Chicken-Fried/Cave-Uno/cave_topo_artwork.png

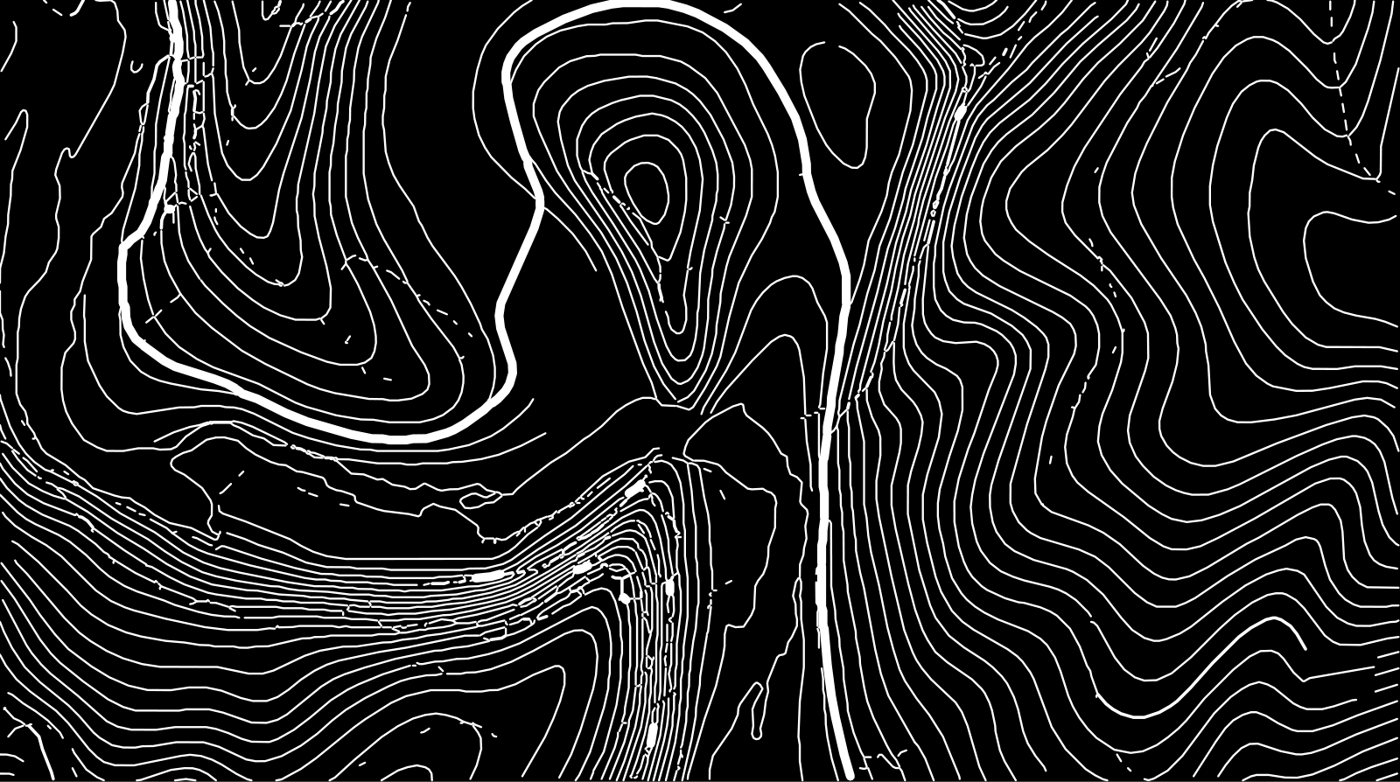
cave_topo_artwork.png
