Chicken-Fried/Cave-Uno/cave_topo_pcb_55pct.png

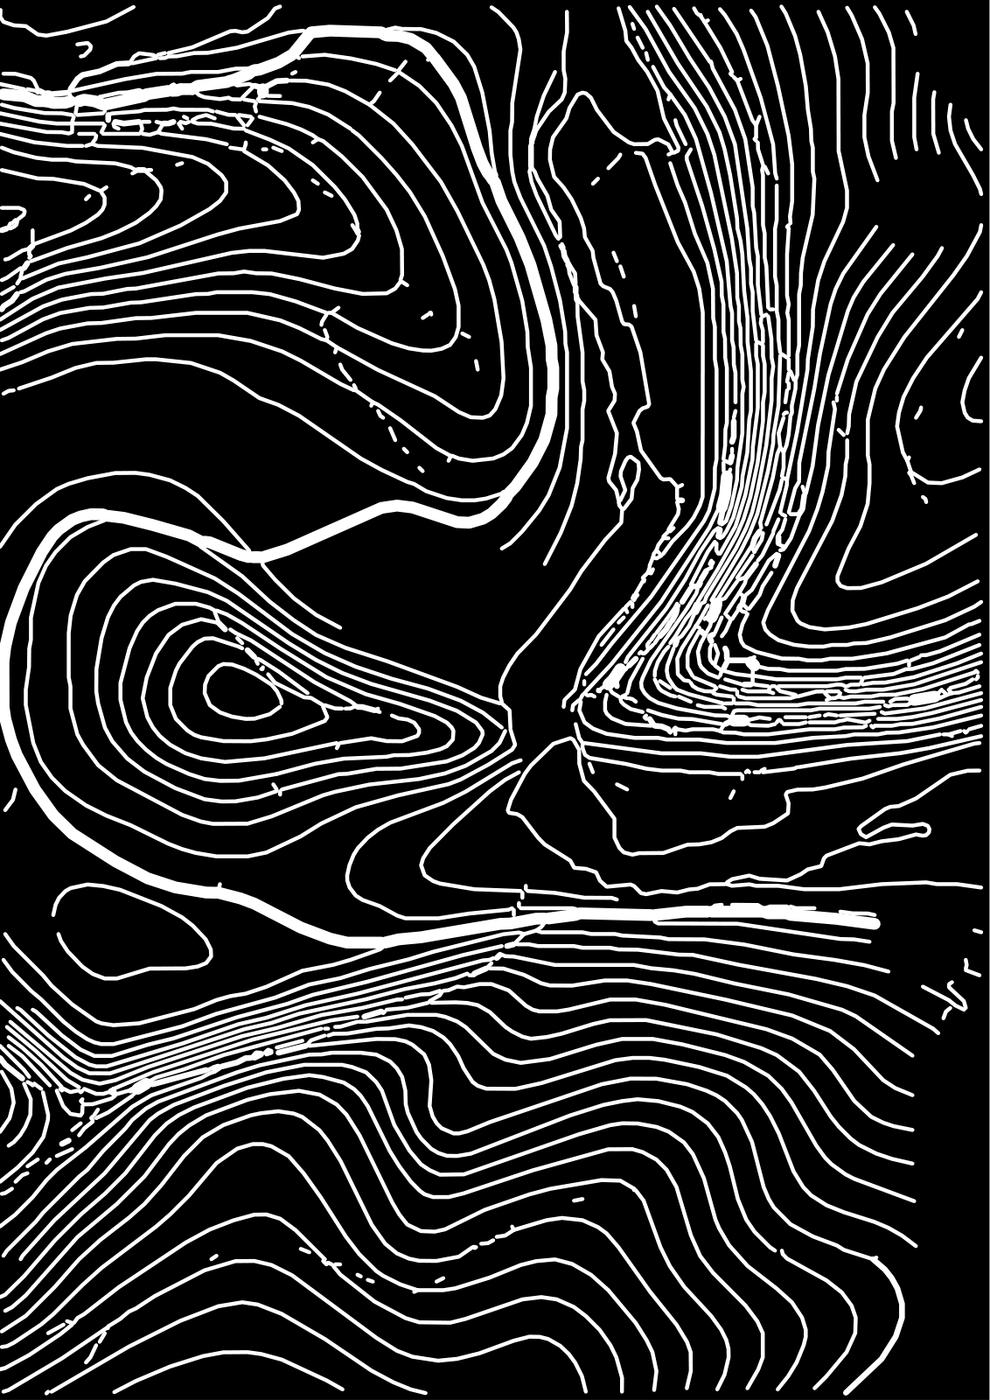
cave_topo_pcb_55pct.png
