Chicken-Fried/Cave-Uno/cave_uno_face_avant_github.png

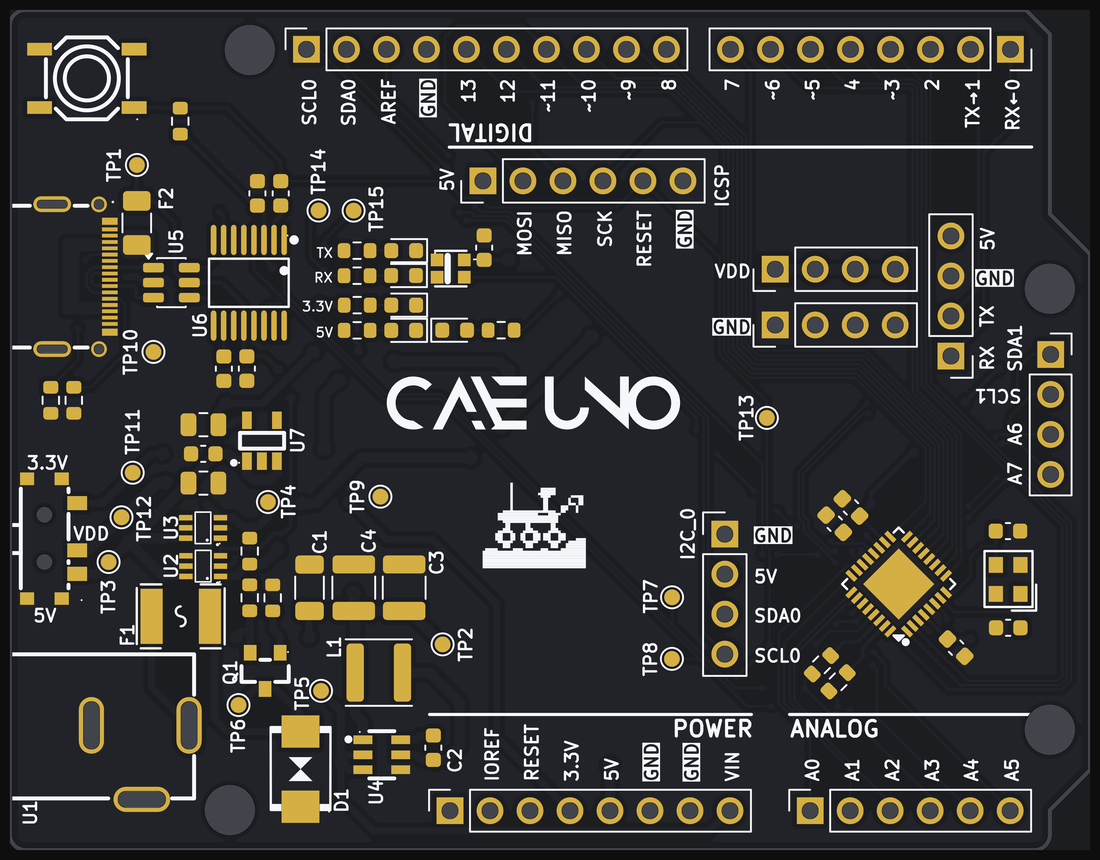
cave_uno_face_avant_github.png
