Chicken-Fried/Cave-Uno/cave_uno_front_portrait.png

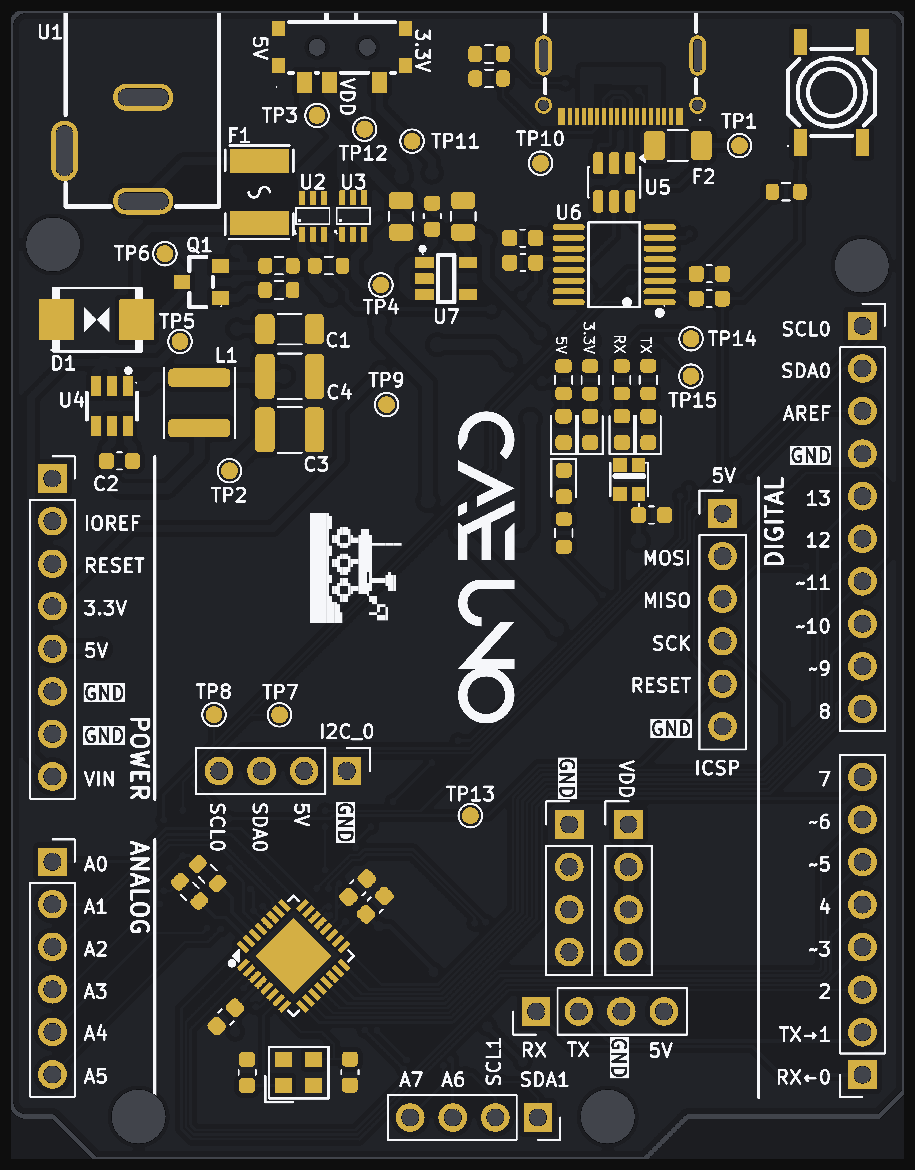
cave_uno_front_portrait.png
