Chicken-Fried/Cave-Uno/arduino_uno.kicad_pcb

## KiCad design arduino_uno.kicad_pcb (2026-10-28)

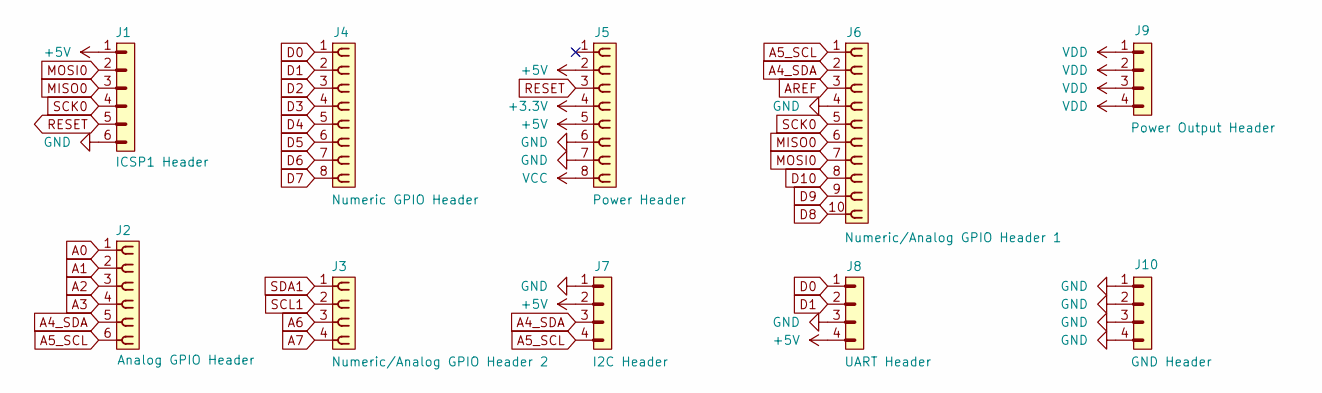
[picture p12: schematic 04_headers_io.kicad_sch]

Parts:
J1: ICSP1 Header; PinHeader_1x06_P2.54mm_Vertical; LCSC Part C505159
J2: Analog GPIO Header; PinSocket_1x06_P2.54mm_Vertical; LCSC Part C5224026
J3: Numeric/Analog GPIO Header 2; PinSocket_1x04_P2.54mm_Vertical; LCSC Part C5116530
J4: Numeric GPIO Header; PinSocket_1x08_P2.54mm_Vertical; LCSC Part C5224027
J5: Power Header; PinSocket_1x08_P2.54mm_Vertical; LCSC Part C5224027
J6: Numeric/Analog GPIO Header 1; PinSocket_1x10_P2.54mm_Vertical; LCSC Part C5116489
J7: I2C Header; PinHeader_1x04_P2.54mm_Vertical; LCSC Part C589358
J8: UART Header; PinHeader_1x04_P2.54mm_Vertical; LCSC Part C589358
J9: Power Output Header; PinHeader_1x04_P2.54mm_Vertical; LCSC Part C41425294
J10: GND Header; PinHeader_1x04_P2.54mm_Vertical; LCSC Part C42391438

Connections:
+3.3V: J5.4; also elsewhere on the board
+5V: J1.1, J5.2, J5.5, J7.2, J8.4; also elsewhere on the board
A0: J2.1; also elsewhere on the board
A1: J2.2; also elsewhere on the board
A2: J2.3; also elsewhere on the board
A3: J2.4; also elsewhere on the board
A4_SDA: J2.5, J6.2, J7.3; also elsewhere on the board
A5_SCL: J2.6, J6.1, J7.4; also elsewhere on the board
A6: J3.3; also elsewhere on the board
A7: J3.4; also elsewhere on the board
AREF: J6.3; also elsewhere on the board
D0: J4.1, J8.1; also elsewhere on the board
D1: J4.2, J8.2; also elsewhere on the board
D2: J4.3; also elsewhere on the board
D3: J4.4; also elsewhere on the board
D4: J4.5; also elsewhere on the board
D5: J4.6; also elsewhere on the board
D6: J4.7; also elsewhere on the board
D7: J4.8; also elsewhere on the board
D8: J6.10; also elsewhere on the board
D9: J6.9; also elsewhere on the board
D10: J6.8; also elsewhere on the board
GND: J1.6, J5.6, J5.7, J6.4, J7.1, J8.3, J10.1, J10.2, J10.3, J10.4; also elsewhere on the board
MISO0: J1.3, J6.6; also elsewhere on the board
MOSI0: J1.2, J6.7; also elsewhere on the board
RESET: J1.5, J5.3; also elsewhere on the board
SCK0: J1.4, J6.5; also elsewhere on the board
SCL1: J3.2; also elsewhere on the board
SDA1: J3.1; also elsewhere on the board
VCC: J5.8; also elsewhere on the board
VDD: J9.1, J9.2, J9.3, J9.4; also elsewhere on the board

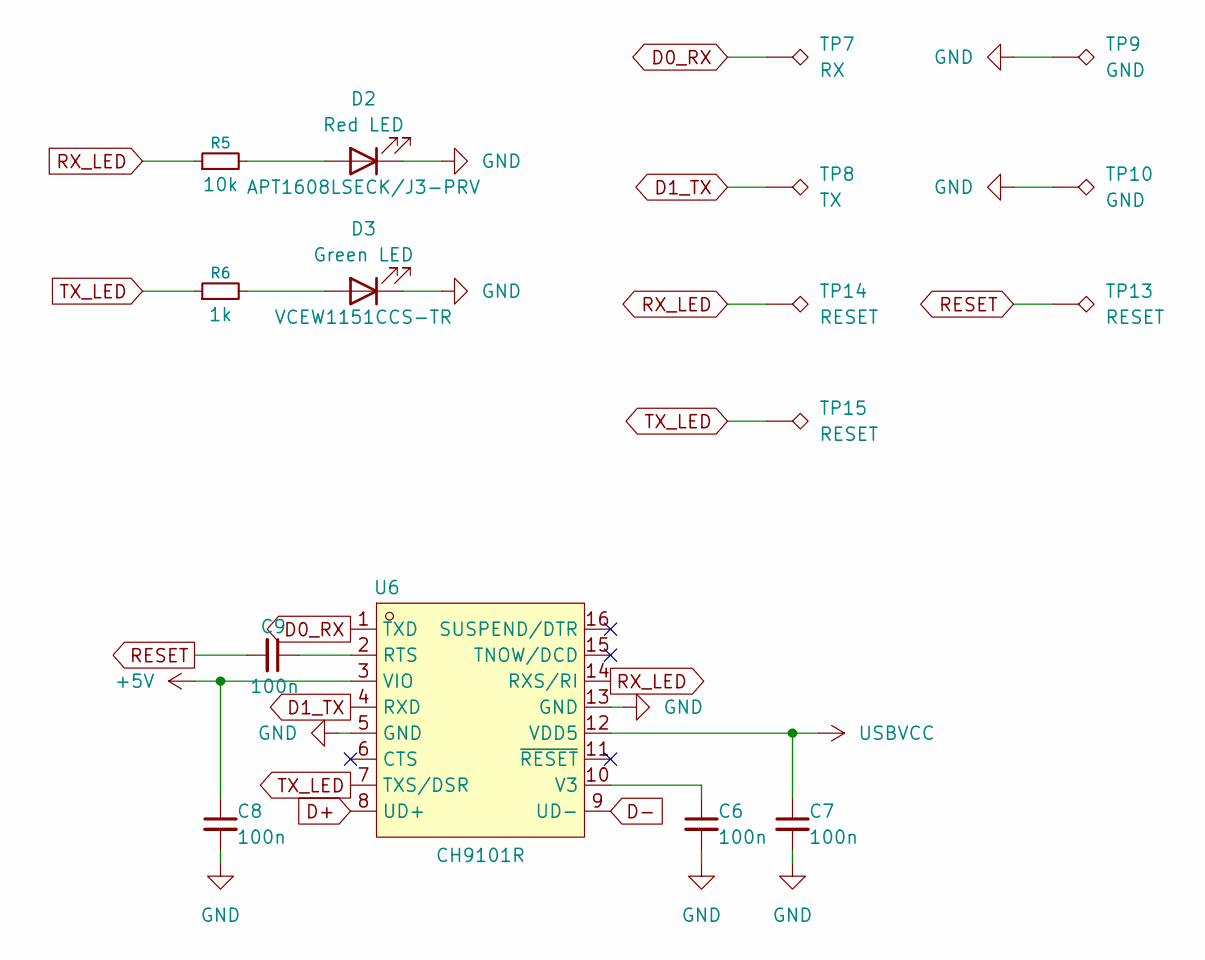
[picture p13: schematic 02_usb_uart.kicad_sch]

Parts:
C6, C7, C8, C9: 100n; C_0603_1608Metric; LCSC Part C346190
D2: Red LED; LED_0603_1608Metric; LCSC Part C5357909
D3: Green LED; LED_0603_1608Metric; LCSC Part C7410054
R5: 10k; R_0603_1608Metric; LCSC Part C191784
R6: 1k; R_0603_1608Metric; LCSC Part C191783
TP7: RX; TestPoint_Pad_D1.0mm
TP8: TX; TestPoint_Pad_D1.0mm
TP9, TP10: GND; TestPoint_Pad_D1.0mm
TP13, TP14, TP15: RESET; TestPoint_Pad_D1.0mm
U6: CH9101R; QSOP-16_L4.9-W3.9-P0.64-LS6.0-BL; MPN CH9101R; LCSC Part C5187520

Connections:
+5V: C8.1, U6.3 (VIO); also elsewhere on the board
D0: TP7.1 (1_1), U6.1 (TXD); also elsewhere on the board
D1: TP8.1 (1_1), U6.4 (RXD); also elsewhere on the board
D+: U6.8 (UD+); also elsewhere on the board
D-: U6.9 (UD-); also elsewhere on the board
GND: C6.2, C7.2, C8.2, D2.1 (K), D3.1 (K), TP9.1 (1_1), TP10.1 (1_1), U6.5 (GND), U6.13 (GND); also elsewhere on the board
unnamed: D2.2 (A), R5.2
unnamed: D3.2 (A), R6.2
unnamed: C9.1, U6.2 (RTS)
unnamed: C6.1, U6.10 (V3)
RESET: C9.2, TP13.1 (1_1); also elsewhere on the board
RX_LED: R5.1, TP14.1 (1_1), U6.14 (RXS/RI)
TX_LED: R6.1, TP15.1 (1_1), U6.7 (TXS/DSR)
USBVCC: C7.1, U6.12 (VDD5); also elsewhere on the board

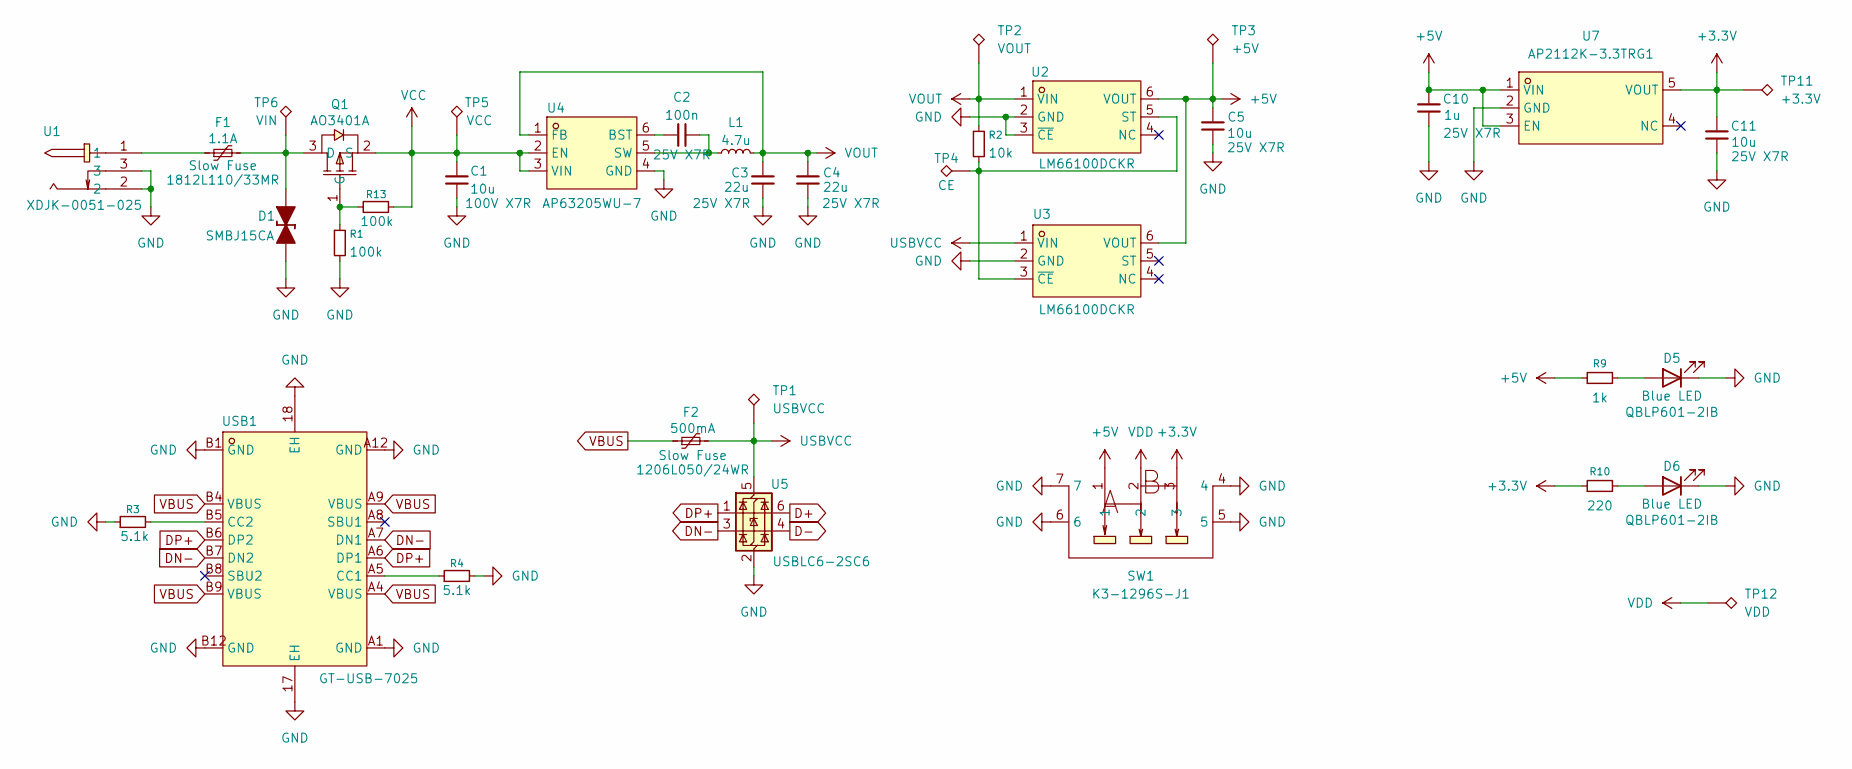
[picture p14: schematic 01_power_management.kicad_sch]

Parts:
C1: 10u; C_1206_3216Metric; LCSC Part C89632
C2: 100n; C_0603_1608Metric; LCSC Part C346190
C3, C4: 22u; C_1210_3225Metric; LCSC Part C2918511
C5, C11: 10u; C_0805_2012Metric; LCSC Part C3039694
C10: 1u; C_0603_1608Metric; LCSC Part C469535
D1: SMBJ15CA; SMB_L4.6-W3.6-LS5.3-BI; LCSC Part C78809
D5, D6: Blue LED; LED_0603_1608Metric; LCSC Part C6629785
F1: 1.1A; F1812; LCSC Part C142747
F2: 500mA; Fuse_1206_3216Metric; LCSC Part C2154056
L1: 4.7u; L_Sunlord_SWPA4030S; LCSC Part C57269
Q1: AO3401A; SOT-23_L2.9-W1.3-P1.90-LS2.4-BR; MPN AO3401A; LCSC Part C15127
R1, R13: 100k; R_0603_1608Metric; LCSC Part C2988967
R2: 10k; R_0603_1608Metric; LCSC Part C191784
R3, R4: 5.1k; R_0603_1608Metric; LCSC Part C191166
R9: 1k; R_0603_1608Metric; LCSC Part C191783
R10: 220; R_0603_1608Metric; LCSC Part C2078042
SW1: K3-1296S-J1; SW-SMD_K3-1296S-J1; MPN K3-1296S-J1; LCSC Part C223848
TP1: USBVCC; TestPoint_Pad_D1.0mm
TP2: VOUT; TestPoint_Pad_D1.0mm
TP3: +5V; TestPoint_Pad_D1.0mm
TP4: CE; TestPoint_Pad_D1.0mm
TP5: VCC; TestPoint_Pad_D1.0mm
TP6: VIN; TestPoint_Pad_D1.0mm
TP11: +3.3V; TestPoint_Pad_D1.0mm
TP12: VDD; TestPoint_Pad_D1.0mm
U1: XDJK-0051-025; DC-IN-TH_XDJK-0051-025; MPN XDJK-0051-025; LCSC Part C7498153
U2, U3: LM66100DCKR; SC-70-6_L2.0-W1.3-P0.65-LS2.1-BL; MPN LM66100DCKR; LCSC Part C2869734
U4: AP63205WU-7; TSOT-23-6_L2.9-W1.6-P0.95-LS2.8-BL; MPN AP63205WU-7; LCSC Part C2071056
U5: USBLC6-2SC6; SOT-23-6; LCSC Part C7519
U7: AP2112K-3.3TRG1; SOT-25-5_L2.9-W1.6-P0.95-LS2.8-BL; MPN AP2112K-3.3TRG1; LCSC Part C51118
USB1: GT-USB-7025; TYPE-C-SMD_GT-USB-7025; MPN GT-USB-7025; LCSC Part C963213

Connections:
+3.3V: C11.1, R10.1, SW1.3, TP11.1 (1_1), U7.5 (VOUT); also elsewhere on the board
+5V: C5.1, C10.1, R9.1, SW1.1, TP3.1 (1_1), U2.6 (VOUT), U3.6 (VOUT), U7.1 (VIN), U7.3 (EN); also elsewhere on the board
D+: U5.6 (I/O1); also elsewhere on the board
D-: U5.4 (I/O2); also elsewhere on the board
DN-: U5.3 (I/O2), USB1.A7 (DN1), USB1.B7 (DN2)
DP+: U5.1 (I/O1), USB1.A6 (DP1), USB1.B6 (DP2)
GND: C1.2, C3.2, C4.2, C5.2, C10.2, C11.2, D1.1 (K), D5.1 (K), D6.1 (K), R1.2, R3.1, R4.2, SW1.4, SW1.5, SW1.6, SW1.7, U1.2, U1.3, U2.2 (GND), U2.3 (~CE), U3.2 (GND), U4.4 (GND), U5.2 (GND), U7.2 (GND), USB1.17 (EH), USB1.18 (EH), USB1.A1 (GND), USB1.A12 (GND), USB1.B1 (GND), USB1.B12 (GND); also elsewhere on the board
unnamed: D1.2 (A), F1.2, Q1.3 (D), TP6.1 (1_1)
unnamed: D5.2 (A), R9.2
unnamed: D6.2 (A), R10.2
unnamed: F1.1, U1.1
unnamed: Q1.1 (G), R1.1, R13.2
unnamed: R2.2, TP4.1 (1_1), U2.5 (ST), U3.3 (~CE)
unnamed: C2.1, U4.6 (BST)
unnamed: C2.2, L1.1, U4.5 (SW)
unnamed: R4.1, USB1.A5 (CC1)
unnamed: R3.2, USB1.B5 (CC2)
USBVCC: F2.2, TP1.1 (1_1), U3.1 (VIN), U5.5 (VBUS); also elsewhere on the board
VBUS: F2.1, USB1.A4 (VBUS), USB1.A9 (VBUS), USB1.B4 (VBUS), USB1.B9 (VBUS)
VCC: C1.1, Q1.2 (S), R13.1, TP5.1 (1_1), U4.2 (EN), U4.3 (VIN); also elsewhere on the board
VDD: SW1.2, TP12.1 (1_1); also elsewhere on the board
VOUT: C3.1, C4.1, L1.2, R2.1, TP2.1 (1_1), U2.1 (VIN), U4.1 (FB)

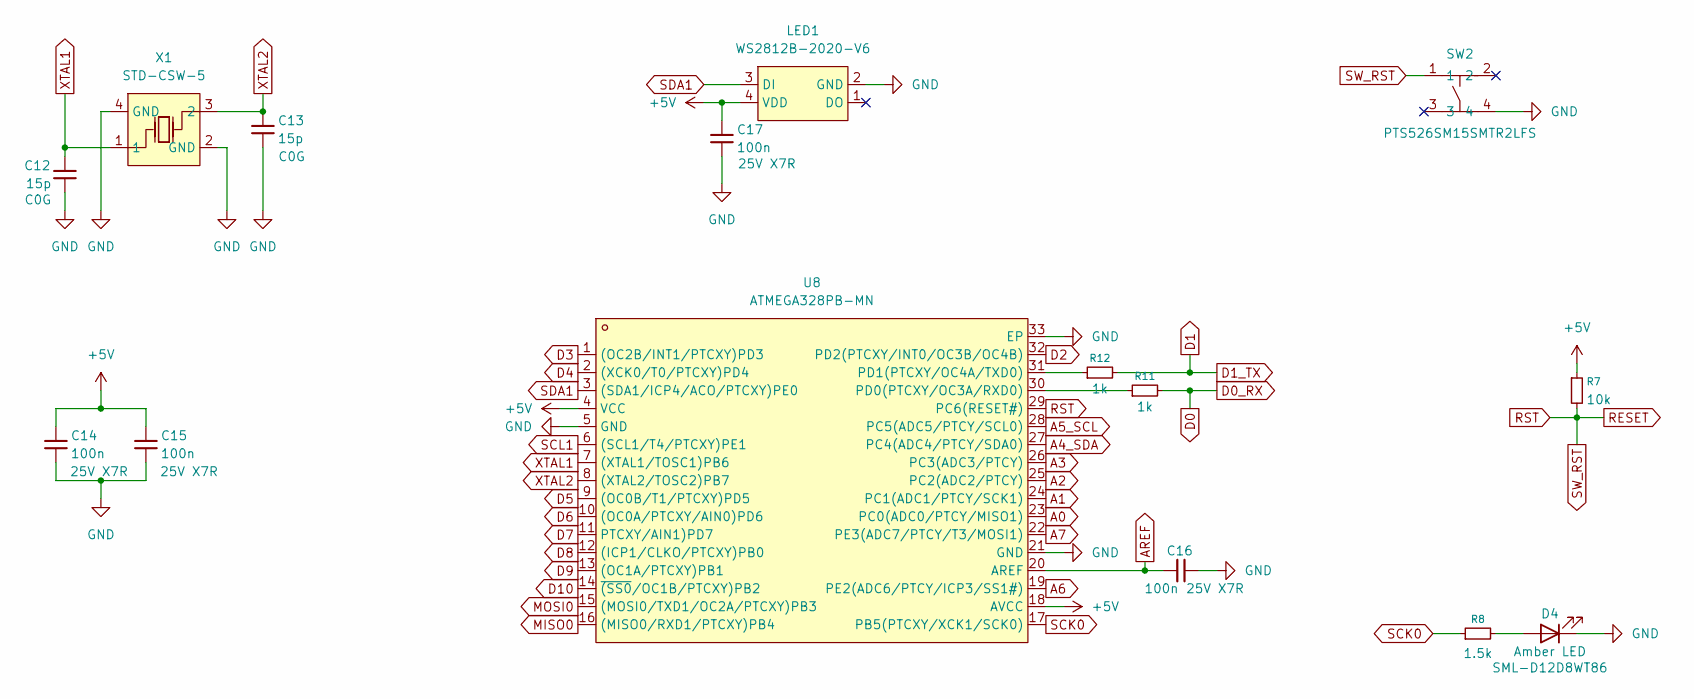
[picture p15: schematic 03_atmega328p_core.kicad_sch]

Parts:
C12, C13: 15p; C_0603_1608Metric; LCSC Part C597069
C14, C15, C16, C17: 100n; C_0603_1608Metric; LCSC Part C346190
D4: Amber LED; LED_0603_1608Metric; LCSC Part C510024
LED1: WS2812B-2020-V6; LED-SMD_4P-L2.2-W2.0-P1.00_WS2815C-2020-4P; MPN WS2812B-2020-V6; LCSC Part C52917434
R7: 10k; R_0603_1608Metric; LCSC Part C191784
R8: 1.5k; R_0603_1608Metric; LCSC Part C2989362
R11, R12: 1k; R_0603_1608Metric; LCSC Part C191783
SW2: PTS526SM15SMTR2LFS; SW-SMD_4P-L5.2-W5.2-P3.70-LS6.4; MPN PTS526SM15SMTR2LFS; LCSC Part C2689538
U8: ATMEGA328PB-MN; QFN-32_L5.0-W5.0-P0.50-TL-EP3.1; MPN ATMEGA328PB-MN; LCSC Part C1337164
X1: STD-CSW-5; CRYSTAL-SMD_4P-L2.5-W2.0-BL-A; MPN NX2520SA-16MHZ-STD-CSW-5; LCSC Part C280836

Connections:
+5V: C14.1, C15.1, C17.1, LED1.4 (VDD), R7.1, U8.4 (VCC), U8.18 (AVCC); also elsewhere on the board
A0: U8.23 (PC0(ADC0/PTCY/MISO1)); also elsewhere on the board
A1: U8.24 (PC1(ADC1/PTCY/SCK1)); also elsewhere on the board
A2: U8.25 (PC2(ADC2/PTCY)); also elsewhere on the board
A3: U8.26 (PC3(ADC3/PTCY)); also elsewhere on the board
A4_SDA: U8.27 (PC4(ADC4/PTCY/SDA0)); also elsewhere on the board
A5_SCL: U8.28 (PC5(ADC5/PTCY/SCL0)); also elsewhere on the board
A6: U8.19 (PE2(ADC6/PTCY/ICP3/SS1#)); also elsewhere on the board
A7: U8.22 (PE3(ADC7/PTCY/T3/MOSI1)); also elsewhere on the board
AREF: C16.1, U8.20 (AREF); also elsewhere on the board
D0: R11.2; also elsewhere on the board
D1: R12.2; also elsewhere on the board
D2: U8.32 (PD2(PTCXY/INT0/OC3B/OC4B)); also elsewhere on the board
D3: U8.1 ((OC2B/INT1/PTCXY)PD3); also elsewhere on the board
D4: U8.2 ((XCK0/T0/PTCXY)PD4); also elsewhere on the board
D5: U8.9 ((OC0B/T1/PTCXY)PD5); also elsewhere on the board
D6: U8.10 ((OC0A/PTCXY/AIN0)PD6); also elsewhere on the board
D7: U8.11 (PTCXY/AIN1)PD7); also elsewhere on the board
D8: U8.12 ((ICP1/CLKO/PTCXY)PB0); also elsewhere on the board
D9: U8.13 ((OC1A/PTCXY)PB1); also elsewhere on the board
D10: U8.14 (~(SS0/OC1B/PTCXY)PB2); also elsewhere on the board
GND: C12.2, C13.2, C14.2, C15.2, C16.2, C17.2, D4.1 (K), LED1.2 (GND), SW2.4, U8.5 (GND), U8.21 (GND), U8.33 (EP), X1.2 (GND), X1.4 (GND); also elsewhere on the board
MISO0: U8.16 ((MISO0/RXD1/PTCXY)PB4); also elsewhere on the board
MOSI0: U8.15 ((MOSI0/TXD1/OC2A/PTCXY)PB3); also elsewhere on the board
unnamed: D4.2 (A), R8.2
unnamed: R11.1, U8.30 (PD0(PTCXY/OC3A/RXD0))
unnamed: R12.1, U8.31 (PD1(PTCXY/OC4A/TXD0))
RESET: R7.2, SW2.1, U8.29 (PC6(RESET#)); also elsewhere on the board
SCK0: R8.1, U8.17 (PB5(PTCXY/XCK1/SCK0)); also elsewhere on the board
SCL1: U8.6 ((SCL1/T4/PTCXY)PE1); also elsewhere on the board
SDA1: LED1.3 (DI), U8.3 ((SDA1/ICP4/ACO/PTCXY)PE0); also elsewhere on the board
XTAL1: C12.1, U8.7 ((XTAL1/TOSC1)PB6), X1.1
XTAL2: C13.1, U8.8 ((XTAL2/TOSC2)PB7), X1.3 (2)

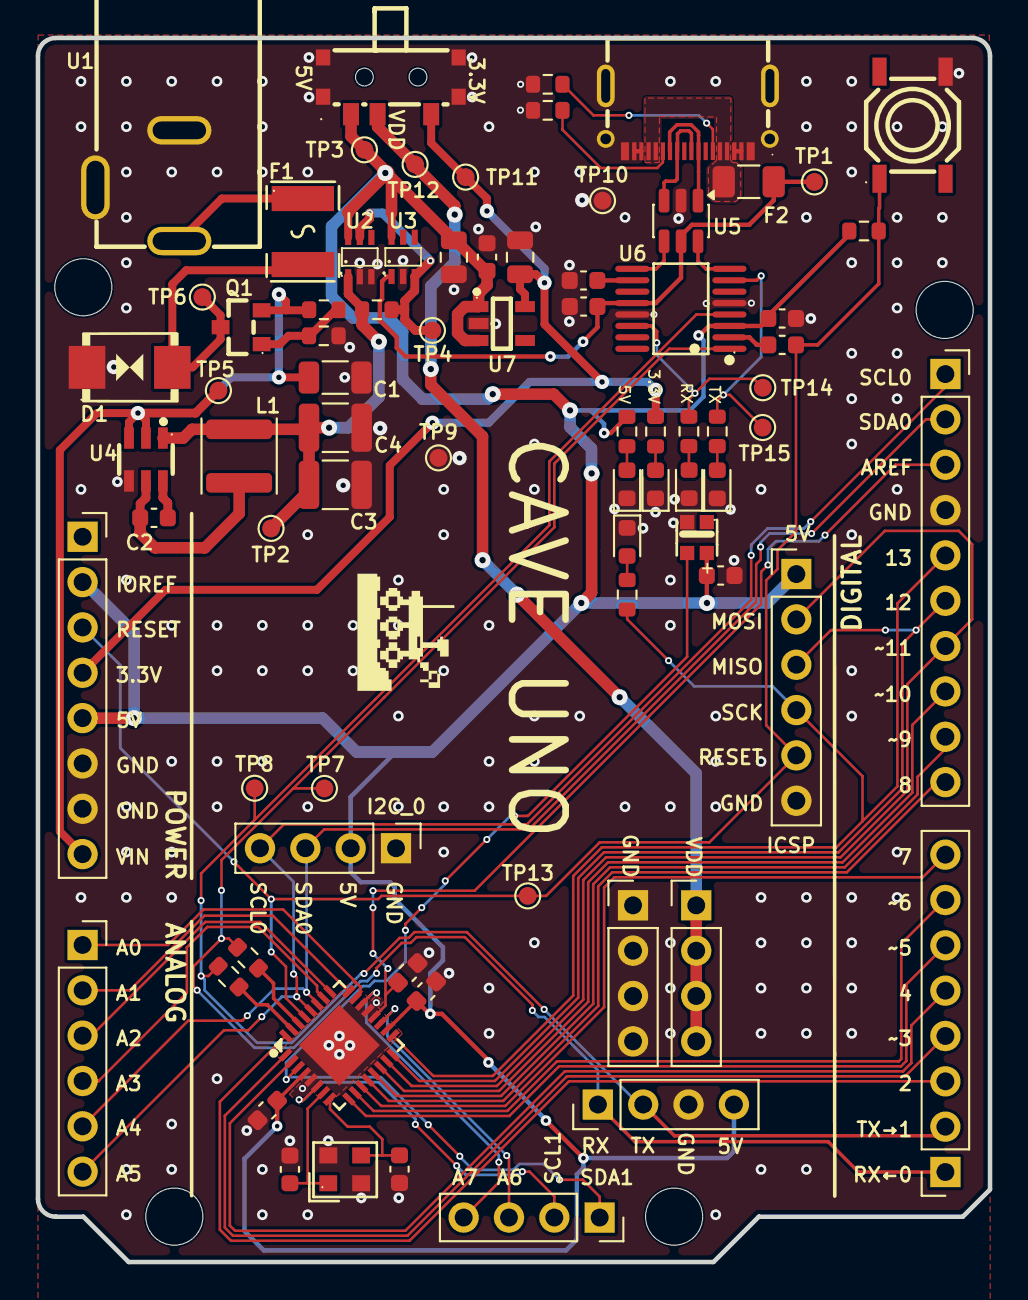
[picture p16: board arduino_uno.kicad_pcb from above]

Board: 2 copper layers, 53.3 x 68.6 mm, 85 parts (1 on the bottom side), 59 nets.

Other parts of the board:
ART1: Artwork_Cave_Topo
LOGO**: Logo_CaveRover_F_SilkS; Logo_CaveRover
LOGO**#2: Logo_CaveRover_F_SilkS; Logo_CaveRover
UNK_HOLE_1, UNK_HOLE_1#2: dummyfp1
UNK_HOLE_2: dummyfp2
UNK_HOLE_3: dummyfp3
