Chicken-Fried/Cave-Uno/(commit log)

2026-10-27 Initial release: Cave Uno Rev 1.0 (KiCad 10 hardware & documentation)
    [01_power_management.kicad_sch, 02_usb_uart.kicad_sch, 03_atmega328p_core.kicad_sch, 04_headers_io.kicad_sch, arduino_uno.kicad_pcb, arduino_uno.kicad_sch]
2026-10-28 Update on the CE pad from the component U2
    [01_power_management.kicad_sch, arduino_uno.kicad_pcb]
