Chicken-Fried/Cave-Uno/(notices)

Notices in the files:
README.md:
Hardware License
